capdoc/ventilator/README.md

# ventilator

Using VSCode with Platform.io extension
It helps maintain the correct library versions
Follow https://docs.platformio.org/en/latest/integration/ide/vscode.html to setup
