capdoc/ventilator/parts list/Arduino Nano V3.docx

1. Arduino Nano V3.0 AVR ATMEGA328P

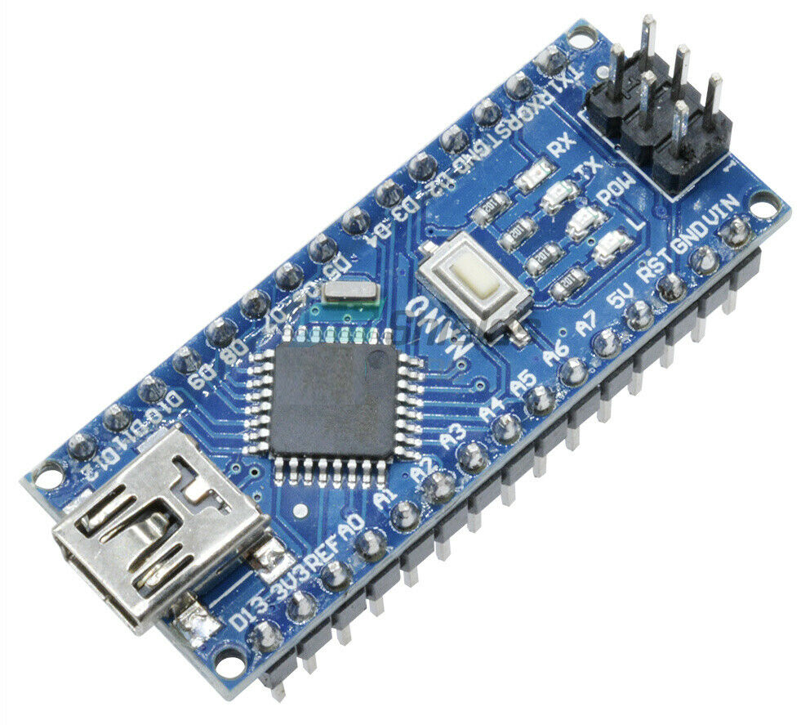
[picture p1: figure]

2. Nano Terminal Adapter Arduino Nano V3.0 AVR ATMEGA328P

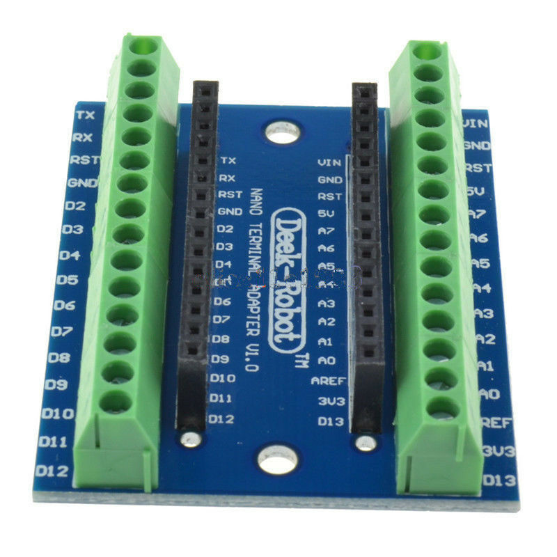
[picture p2: figure]

3. B10K OHM Linear Taper Rotary Potentiometer 15mm Shaft With Dial x3

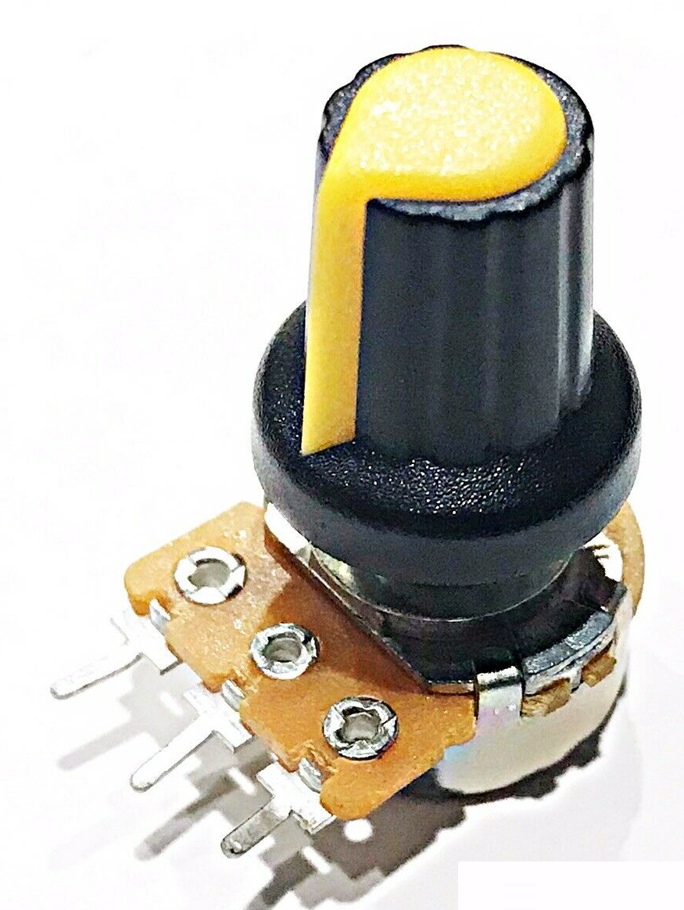
[picture p3: figure]

4. 1x Red LED 2V and 1x Green LED 2V 8mm Panel hole

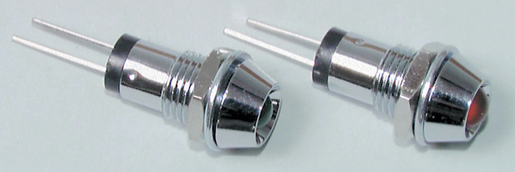
[picture p4: figure]

5. 2 x 220 resistors
6. 1 x SPDT Miniature Toggle Switch - Solder Tag

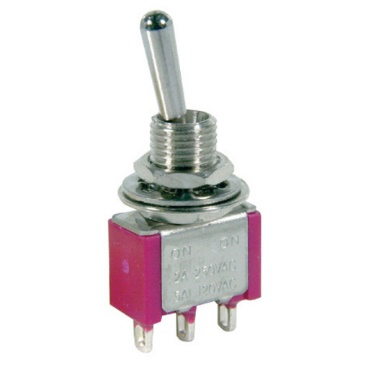
[picture p5: figure]
SPDT Miniature Toggle Switch - Solder Tag

7. 3 x Pushbutton PUSH-ON MOMENTARY SPST RED ACTUATOR 6mm dia

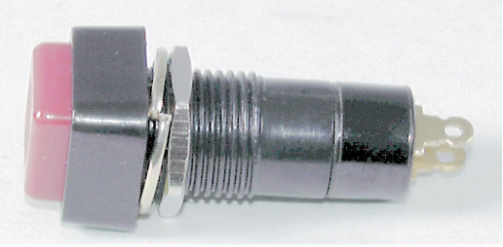
[picture p6: figure]

8. Nema23 Stepper Motor – minimum =>2.45N.m

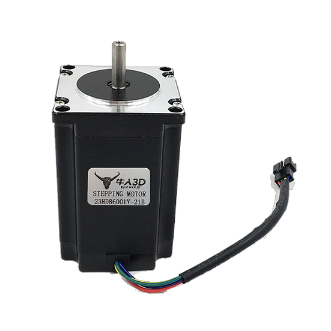
[picture p7: figure]

9. TB6600 Driver Single Axis 4A Controller 9~42VDC for Stepper Motor NEMA23

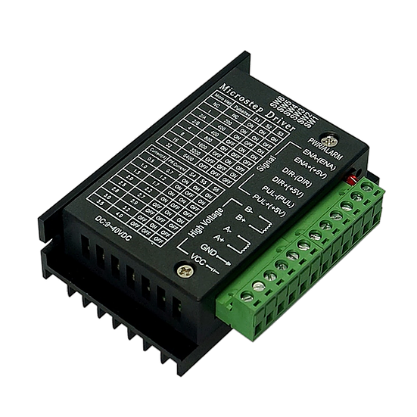
[picture p8: figure]

10. 4 Line LCD with I2C backpack
  a. LCD2004 LCD display with I2C module for Arduino

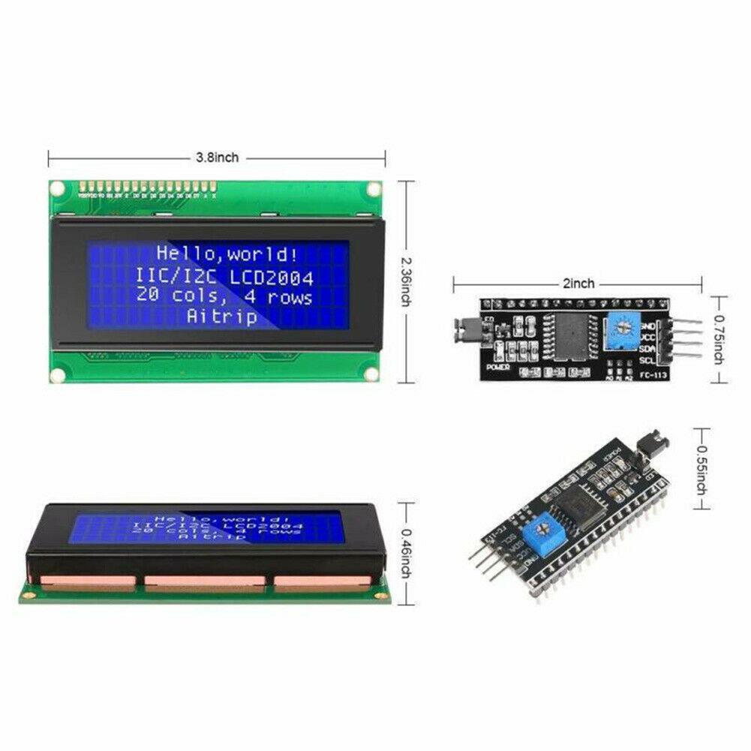
[picture p9: figure]

11. SPDT 125V 3A Sub-Miniature Micro Switch with Lever

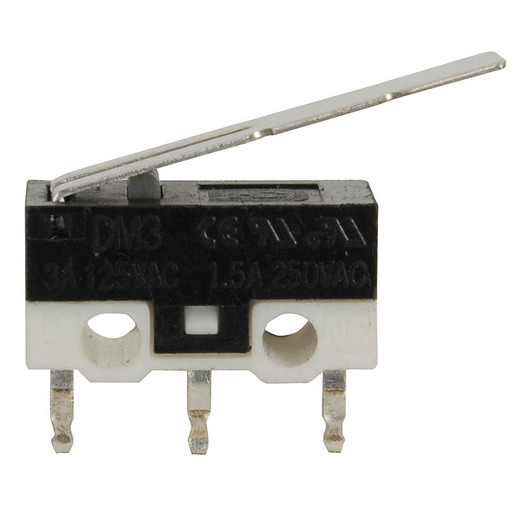
[picture p10: figure]

12. Compatible DC Voltage Regulator

• Input voltage 4.5-35V
• Output voltage 3-34V
• Maximum output current 2.5A

DC - DC buck converter module Voltage Step Down Converter Module

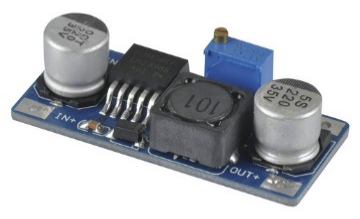
[picture p11: figure]
Arduino Compatible DC Voltage Regulator

13. 65mm PVC plumbing DWV Straight Coupling

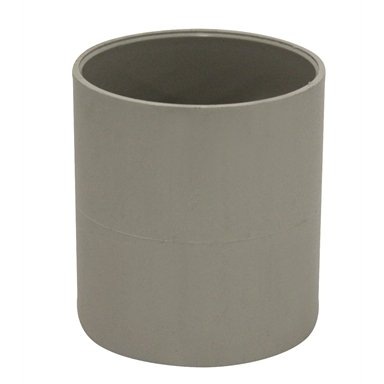
[picture p12: figure]
Holman 65mm PVC DWV Straight Coupling

14. Grunt 2mm White High quality braided polyester cord (non-stretch)
  a. Measure 14 inches tie off at 12 or 13

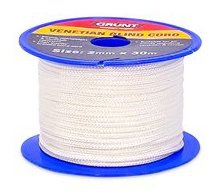
[picture p13: figure]
Grunt 2mm x 30m White Venetian Blind Cord

15. 2 medium sized zip ties
16. Lots of different colour wires for joining components
17. M5 x 35mm 316 Stainless Steel Screw Round Head Bolt And Nut - 4 Pack
18. M5 x 80mm Screw Round Head Bolt
19. M5 Stainless Steel Nylon Lock Nut x1
20. Zenith 1/4" And M6 Nylon Washers x6
21. 2mm x 20mm nut and bolt x 2
