capdoc/ventilator/3dparts/Mask holder/mask holder.SLDPRT

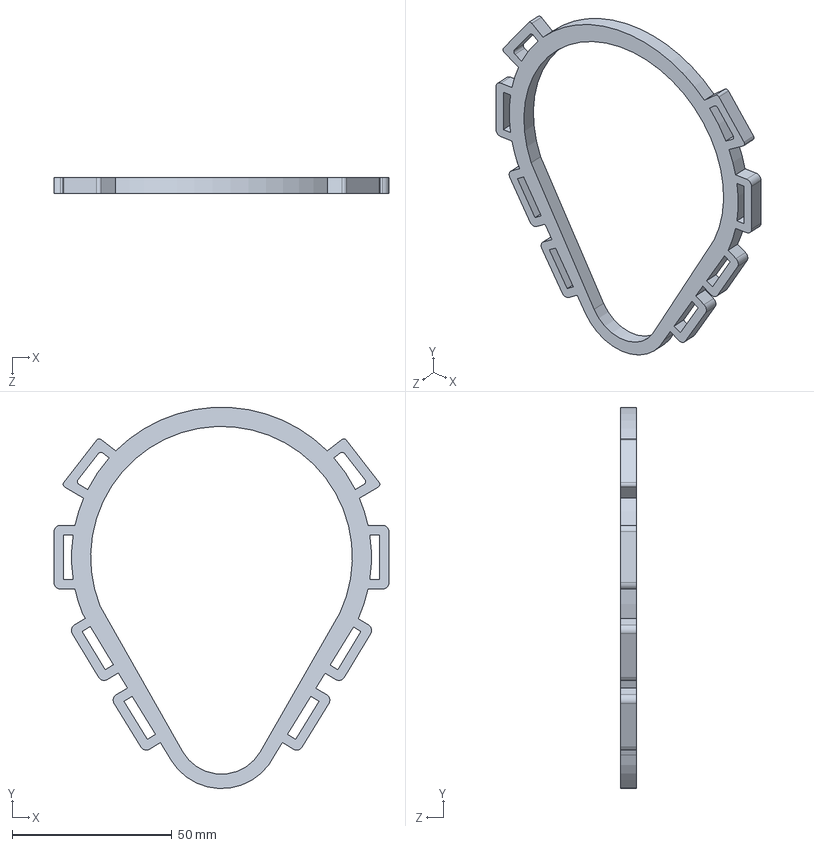
[picture p14: CAD file, 2020-04-22]
3dparts/Mask holder/mask holder.SLDPRT
105.0 x 119.4 x 5.00 mm
