capdoc/ventilator/3dparts/Spool/Nema 23/nema23_shaft_one hole middle.SLDPRT

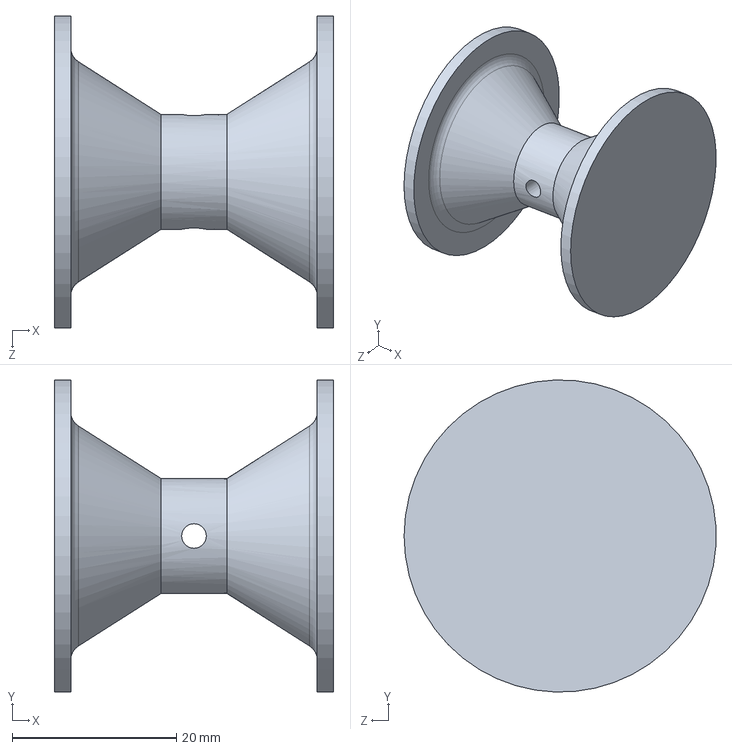
[picture p15: CAD file, 2020-04-11]
3dparts/Spool/Nema 23/nema23_shaft_one hole middle.SLDPRT
34.0 x 38.0 x 38.0 mm
