capdoc/ventilator/laser cutter files/6mm-Arm.dxf

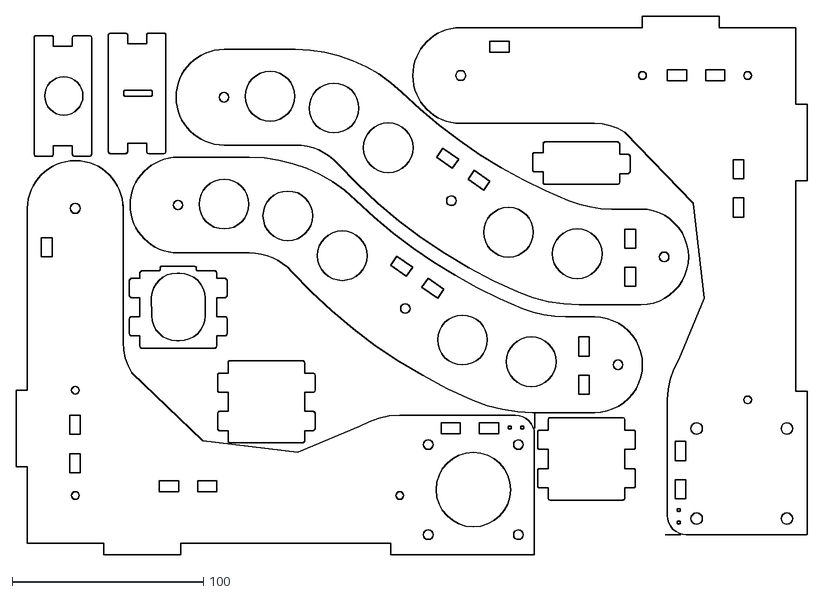
[picture p16: CAD file, 2020-04-30]
laser cutter files/6mm-Arm.dxf
413.5 x 281.6
