capdoc/ventilator/laser cutter files/6mm-Sides.dxf

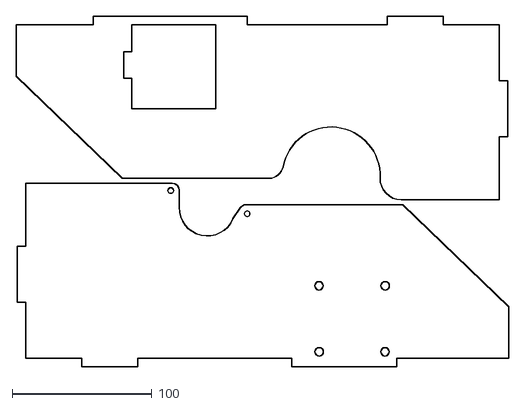
[picture p17: CAD file, 2020-04-12]
laser cutter files/6mm-Sides.dxf
351.8 x 250.3
