capdoc/ventilator/laser cutter files/3mm-bagPlates.dxf

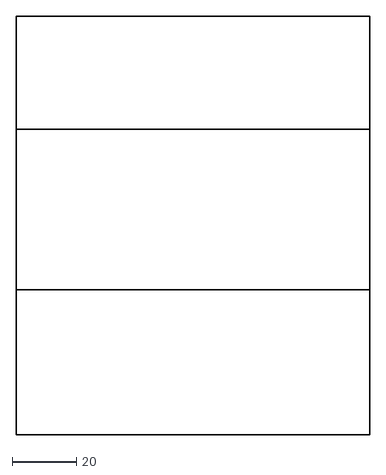
[picture p18: CAD file, 2020-04-11]
laser cutter files/3mm-bagPlates.dxf
110.0 x 130.0
