capdoc/ventilator/laser cutter files/6mm-Backs.dxf

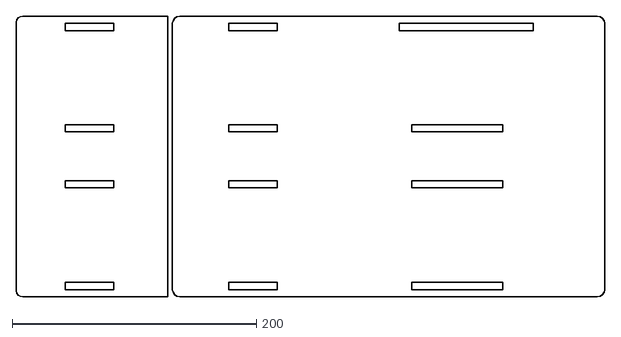
[picture p19: CAD file, 2020-04-11]
laser cutter files/6mm-Backs.dxf
481.9 x 230.0
