capdoc/ventilator/laser cutter files/3mm-Face.dxf

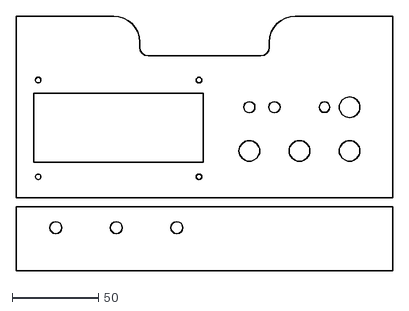
[picture p20: CAD file, 2020-04-11]
laser cutter files/3mm-Face.dxf
218.0 x 147.4
