capdoc/ventilator/(list of files, cad)

Other CAD files:
3dparts/Mask holder/mask holder.STL
3dparts/Spool/Nema 23/nema23_shaft_one hole middle.STL
