capdoc/ventilator/wiring diagram/Schematic_Vent101_2020-07-01_21-12-22.pdf

# U1TB6600

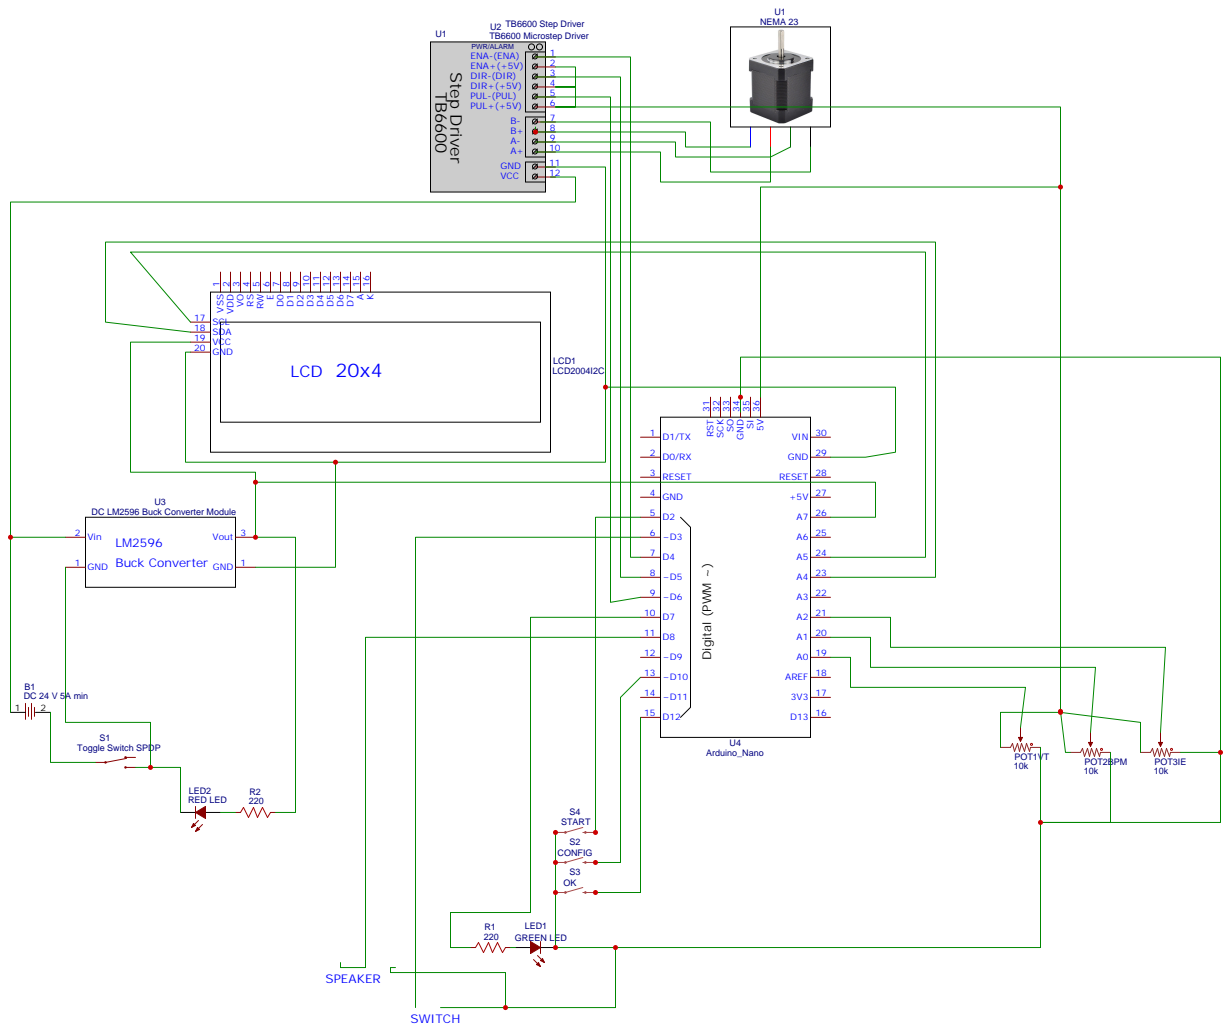
[picture p21: page 1]
