capdoc/ventilator/parts list/Schematic_Vent101_2020-04-30_23-41-00.pdf

# U1TB6600

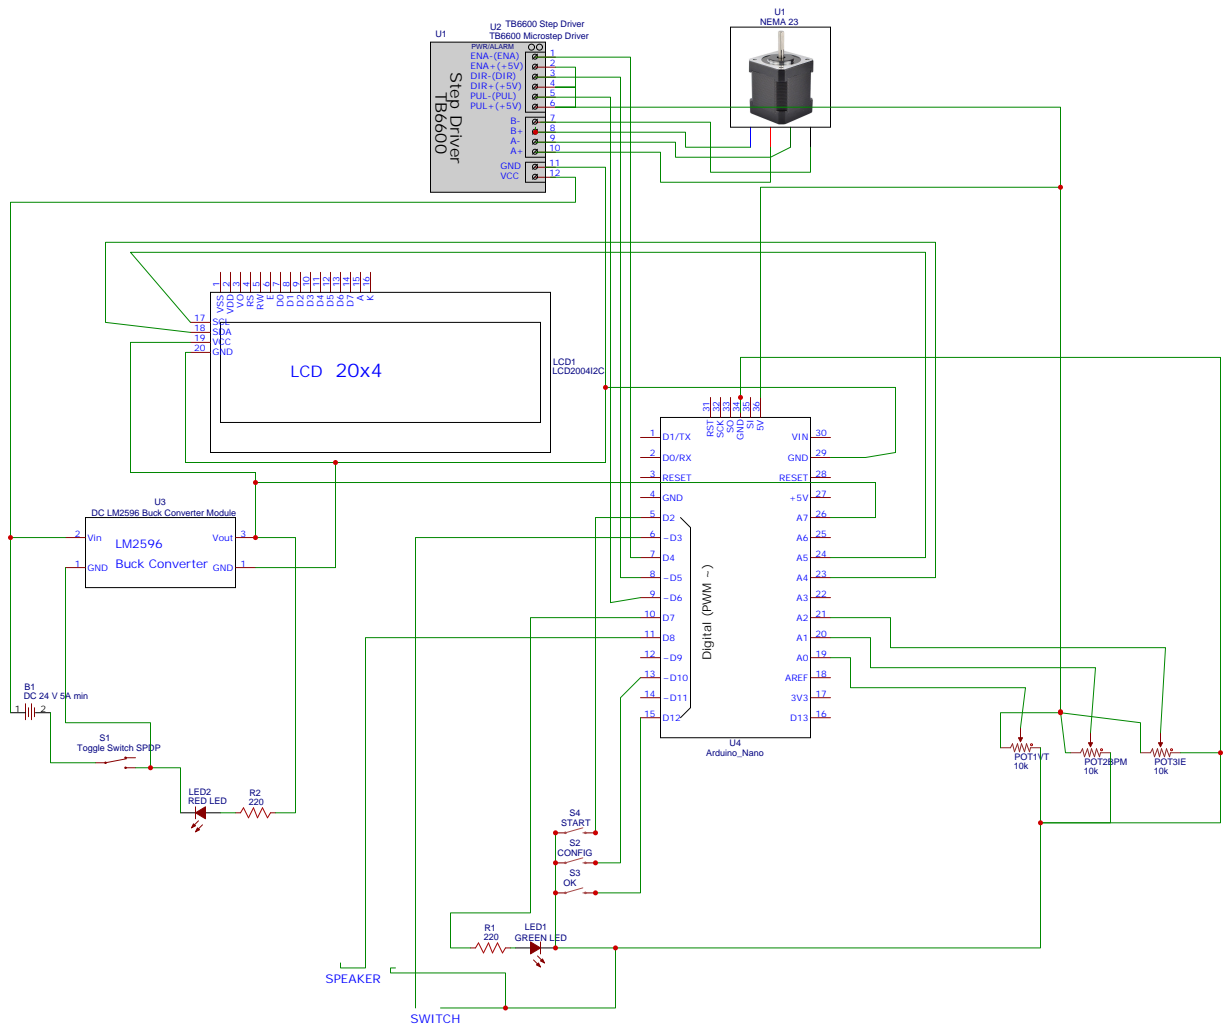
[picture p22: page 1]
