capdoc/ventilator/(commit log)

2020-04-11 recovery from branch!!!
    [#6mm-Arm.dxf, 3mm-Face.dxf, 3mm-bagPlates.dxf, 6mm-Arm.dxf, 6mm-Arm_v2.dxf, 6mm-Backs.dxf, 6mm-Sides.dxf, Part1.SLDPRT]
2020-04-12 laser cut files update
    [6mm-Arm.dxf, 6mm-Arm_v2.dxf, 6mm-Sides.dxf, Part1.SLDPRT]
2020-04-14 increment setting working - setting array and cancelling
    [3mm-Face.dxf, ratios.xlsx]
2020-04-14 resetting arm to previous valid position - ready to start breathing
    [main.cpp]
2020-04-15 forgot to uncomment bracket
2020-04-20 3d park cleanup
    [6mm-Arm.dxf, Respiratory System Part 1.stl, Spool v1-2-0.stl, Spool2.stl, mask holder.SLDPRT, mask holder.STL, mask holder2.SLDPRT, mask holder2.STL]
2020-04-21 mask holder updates
    [mask holder2.SLDPRT, mask holder4.STL]
2020-04-22 mask update
    [mask holder2.SLDPRT, mask holderFFF.STL]
2020-04-22 fixed spelling mistake on warning
    [main.cpp]
